Securitybits-io/HiDIYous/docs/img/ArduinoIDE_ISP_Sketch.png

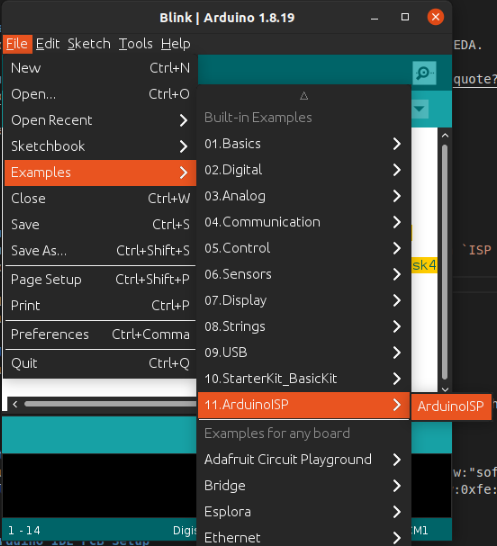
docs/img/ArduinoIDE_ISP_Sketch.png
