Securitybits-io/HiDIYous/hardware/BOM.csv

ID | Name | Designator | Footprint | Quantity | Manufacturer Part | Manufacturer | Supplier | Supplier Part | Price
1 | 3.6v | D1,D2 | SOD-323_L1.7-W1.3-LS2.7-RD | 2 | BZT52C3V6S | BORN伯恩半导体 | LCSC | C511895 | 0.017
2 | 68 | R1,R2 | R0603 | 2
3 | 1.5k | R3 | R0603 | 1
4 | ATTINY85-20SU | U1 | SOIC-8_L5.3-W5.3-P1.27-LS8.0-BL | 1 | ATTINY85-20SU | MICROCHIP(美国微芯) | LCSC | C89852 | 3.361
