Securitybits-io/HiDIYous/hardware/Schematic.pdf

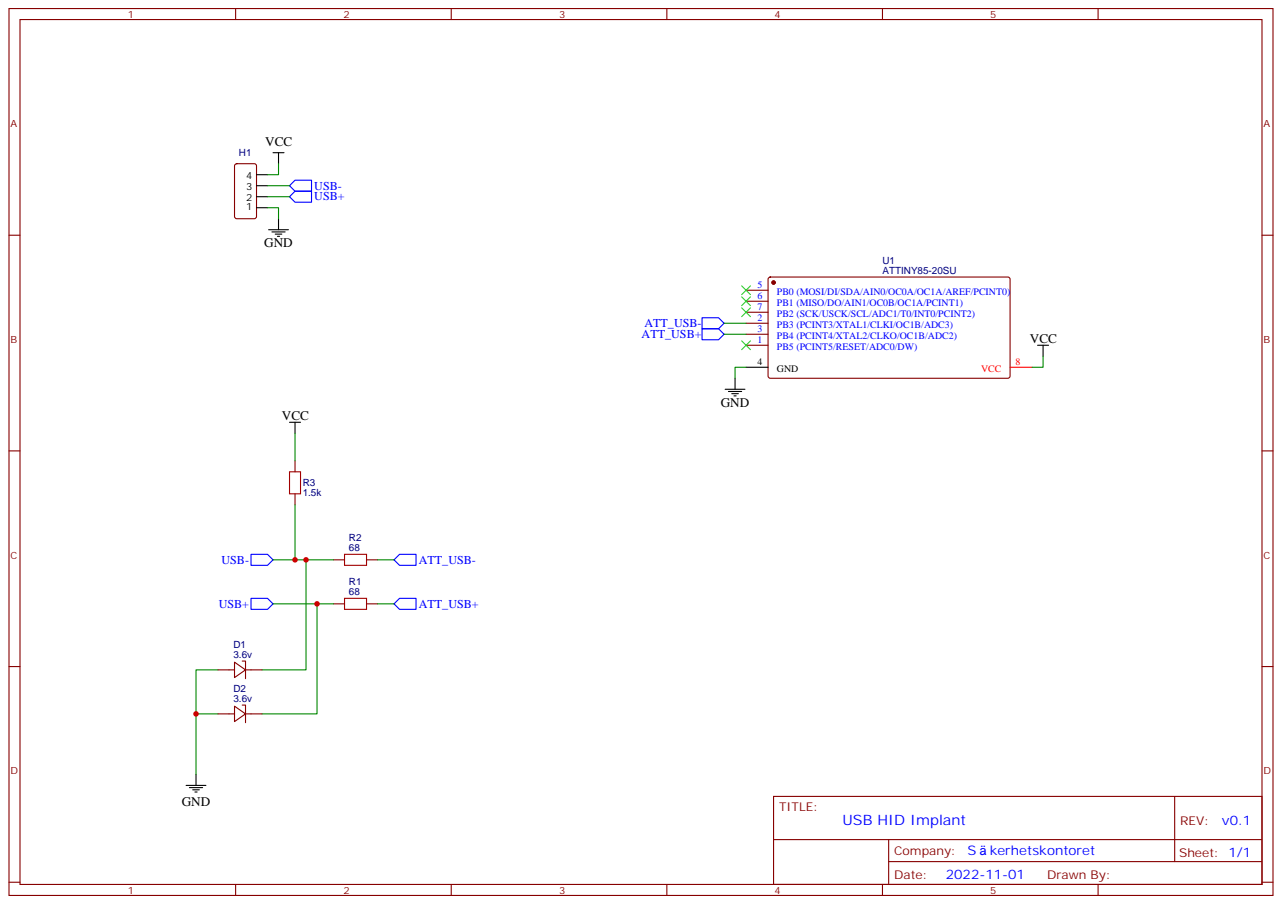
[picture p5: page 1]
