Securitybits-io/HiDIYous/hardware/Schematic.pdf

### USB-USB+
